LucasPifo/Sensor-Magnetico-Wifi/(list of files, drawings)

Other design files:
Proyecto proteus/Circuito.pdsprj
