LucasPifo/Sensor-Magnetico-Wifi/(notices)

Notices in the files:
README.md:
License: MIT
